alvaro-MM/uroflujometro/infografia/uroflujometro-infografia-v01.png

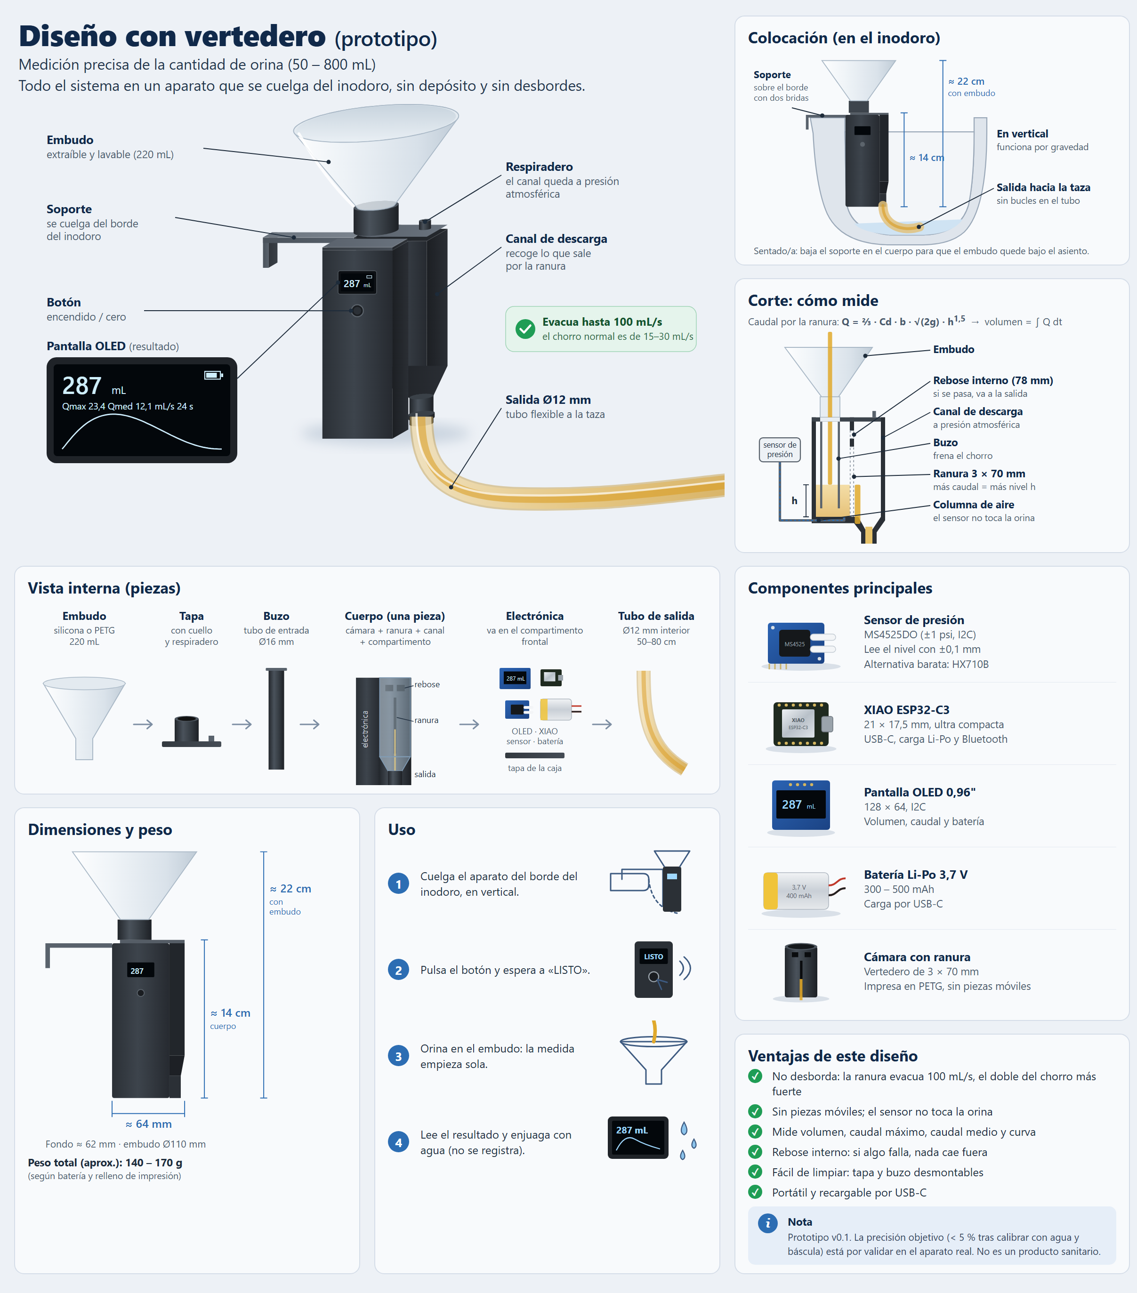
infografia/uroflujometro-infografia-v01.png
