alvaro-MM/uroflujometro/infografia/uroflujometro-infografia-v02.png

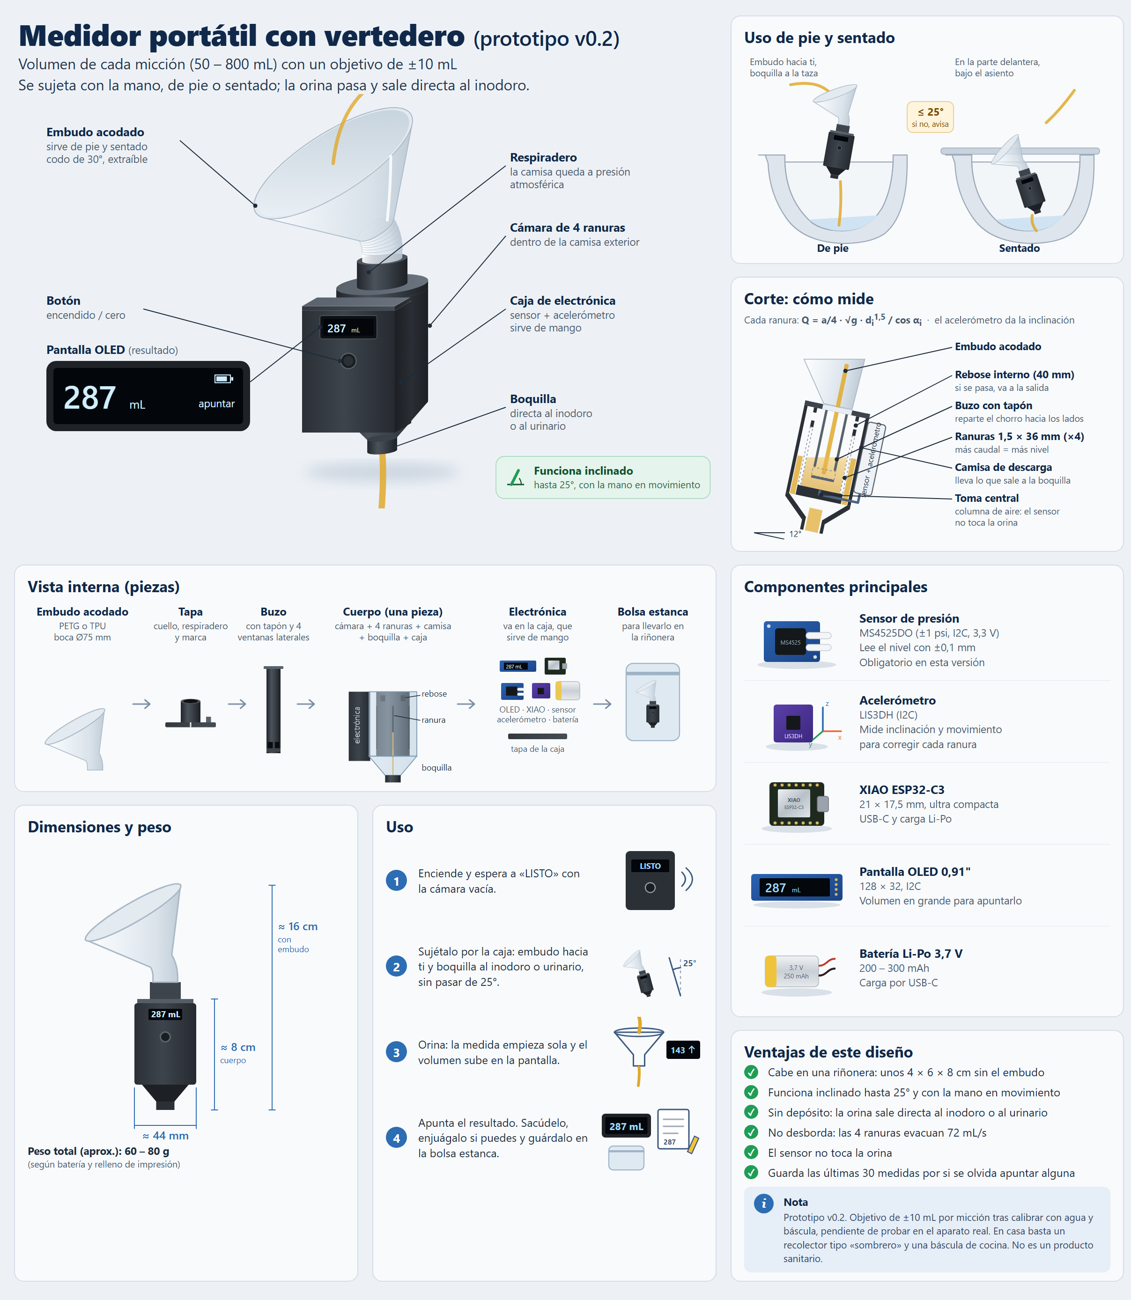
infografia/uroflujometro-infografia-v02.png
